pabloMartinGit/SEyTR_GII-G13-Consola_Arduino/(commit log)

2024-04-28 Script en Python para carga de videojuegos
2024-05-07 Rename esquema final_bb.jpg to Esquema de montaje
